JoseRueda1/riscv-single-cycle/README.md

# Procesador RISC-V single-cycle en SystemVerilog

Parcial 4 – Arquitectura de Computadoras, UNIS.
Autor: José Rueda (carné 18123).

Procesador RISC-V de **un solo ciclo** (single-cycle) descrito en SystemVerilog, basado en el capítulo 7 de *Digital Design and Computer Architecture* (Harris & Harris) y en el repositorio de referencia indicado en el curso. Cada instrucción se completa en un ciclo de reloj: fetch, decode, execute, memory y write-back.

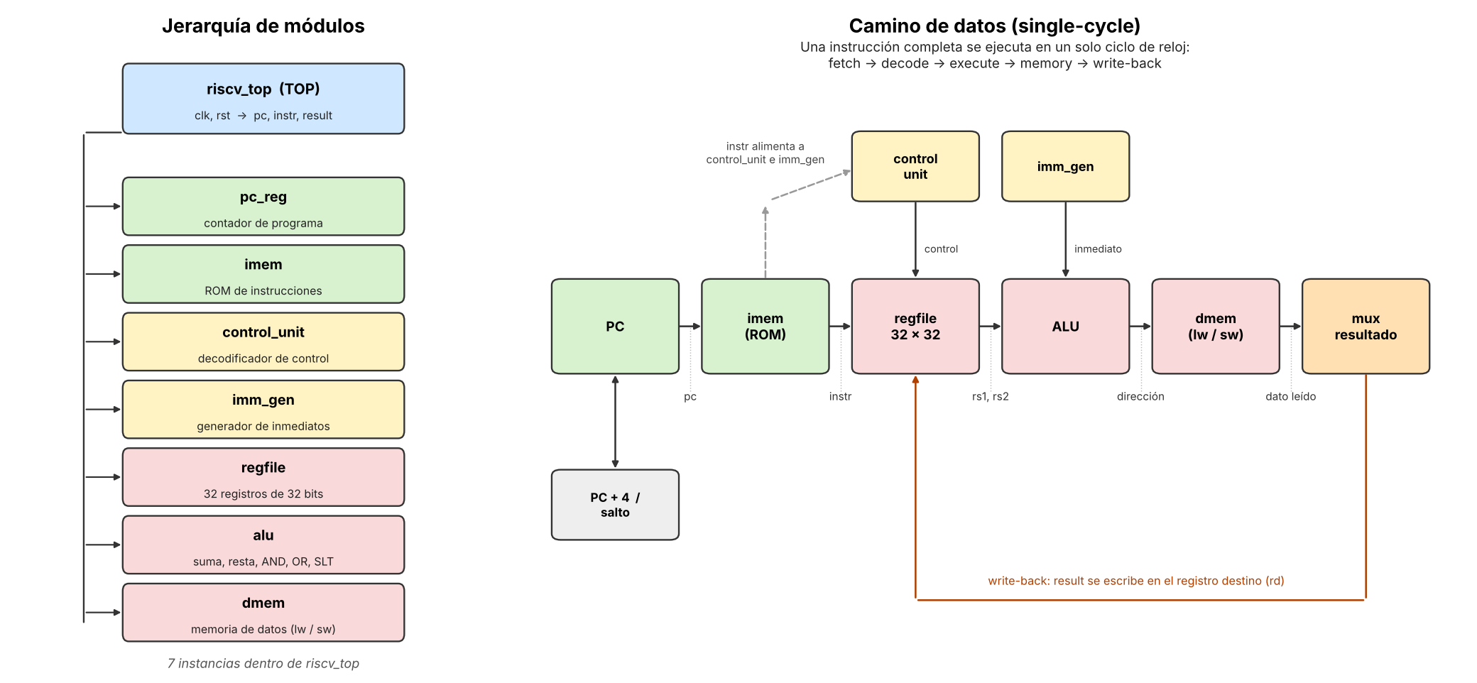
[picture p1: diagrama_jerarquia_y_datapath.png]
Jerarquía y camino de datos


## Instrucciones soportadas

Se implementó el subconjunto del video, más `addi` y `jal`, que el mismo video presenta como las siguientes en agregarse.

| Tipo | Instrucciones |
|---|---|
| Aritmético-lógicas (R) | `add`, `sub`, `and`, `or`, `slt` |
| Con inmediato (I) | `addi` |
| Memoria | `lw`, `sw` |
| Saltos condicionales (B) | `beq` |
| Salto incondicional (J) | `jal` |

Una instrucción no soportada se ejecuta como si fuera un NOP: no escribe registros ni memoria.

## Archivos

| Archivo | Descripción |
|---|---|
| `riscv_top.sv` | **TOP**. Conecta todos los bloques. Puertos: `clk`, `rst`, y salidas de observación `pc`, `instr`, `result`. Parámetro `DMEM_WORDS` (por defecto 16) |
| `pc_reg.sv` | Contador de programa, reset síncrono |
| `imem.sv` | Memoria de instrucciones (ROM combinacional con el programa de prueba) |
| `control_unit.sv` | Decodificador principal y decodificador de la ALU |
| `imm_gen.sv` | Generador de inmediatos (tipos I, S, B y J) |
| `regfile.sv` | Banco de 32 registros de 32 bits, 2 lecturas combinacionales y 1 escritura síncrona; `x0` siempre vale 0 |
| `alu.sv` | ALU: suma, resta, AND, OR y SLT con signo |
| `dmem.sv` | Memoria de datos (lectura combinacional, escritura síncrona) |
| `tb_riscv_top.sv` | Testbench autoverificable |
| `expected.svh` | Valores esperados (registros y memoria) generados por el simulador de referencia |
| `gen_program.py` | Mini ensamblador RV32I + simulador de referencia en Python; genera `imem.sv`, `expected.svh` y `program.hex` |
| `program.hex` | Programa de prueba en hexadecimal |
| `files.f` | Lista de archivos para VCS |
| `resultado_simulacion_*.log` | Salida de las simulaciones |

## Programa de prueba

El programa (41 instrucciones, 73 ciclos hasta su bucle final) ejercita todas las instrucciones:

- Operaciones aritmético-lógicas con valores positivos y negativos (`add`, `sub`, `and`, `or`, `slt` con signo).
- `sw` y `lw` con comprobación de lo leído.
- `beq` tomados y no tomados (cuatro en el código, uno de ellos dentro del bucle).
- `jal` con enlace.
- Un bucle que suma 10 + 9 + ... + 1 y guarda **55** en la memoria de datos.

## Cómo verificarlo

El testbench ejecuta el programa hasta el bucle final y compara **todos los registros escritos y la memoria de datos** contra los valores que calcula el simulador de referencia en Python (`gen_program.py`), que es independiente del RTL. Termina con la línea `Errores: N`.

### Icarus Verilog

```sh
iverilog -g2012 -o sim.vvp -s tb_riscv_top pc_reg.sv regfile.sv imm_gen.sv alu.sv control_unit.sv dmem.sv imem.sv riscv_top.sv tb_riscv_top.sv
vvp sim.vvp
```

### Synopsys VCS / Verdi

```sh
vcs -full64 -sverilog -kdb -debug_access+all -f files.f -o simv
./simv -no_save
verdi -dbdir simv.daidir -ssf dump_riscv.fsdb &
```

### AMD Vivado

Se creó un proyecto RTL para el Artix-7 `xc7a35tcpg236-1`. Archivos de diseño: los 8 `.sv` del procesador (`riscv_top` como top). Archivos de simulación: `tb_riscv_top.sv` y `expected.svh`. Restricción de reloj en `riscv.xdc`:

```
create_clock -period 12.000 -name clk [get_ports clk]
```

## Resultados

### Verificación funcional

| Herramienta | Resultado |
|---|---|
| Icarus Verilog 12 | `Errores: 0` (73 ciclos, 776 ns) |
| Synopsys VCS X-2025.06-SP2-6 | `Errores: 0` (73 ciclos, 776 ns) |
| Vivado Simulator 2025.1 | `Errores: 0` (73 ciclos, 776 ns) |

Para comprobar que el testbench detecta fallas, se introdujeron 7 errores a propósito en el diseño (`sub` implementado como suma, `slt` sin signo, `beq` invertido, `jal` que guarda el PC equivocado, inmediato de `sw` mal armado, `or` implementado como `and` y `lw` que devuelve la salida de la ALU). El testbench detectó los 7.

### Evidencia de VCS y Verdi

Primeras instrucciones: `pc` avanza de 4 en 4, `instr` muestra cada instrucción y `result` el dato que se escribe (10, 5, 15, 5, 0, 15, 1, 0, -3, ...).

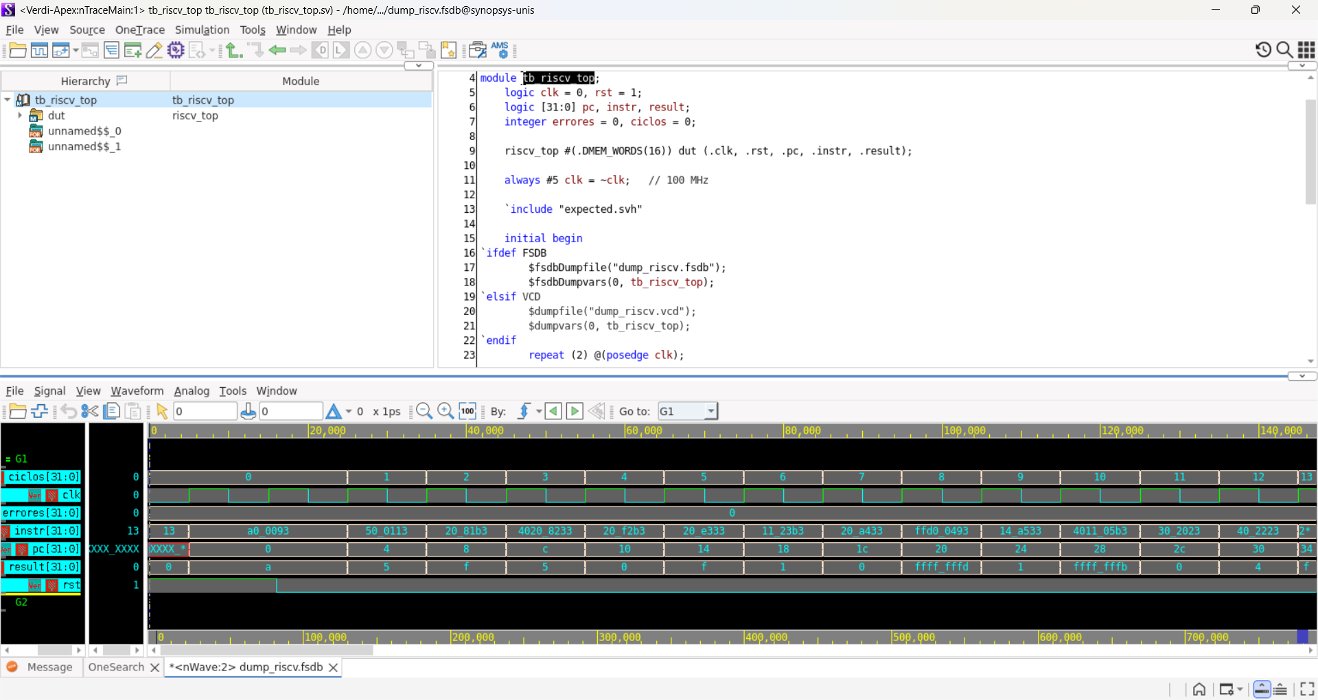
[picture p2: evidencia/01_verdi_primeras_instrucciones.png]
Verdi: primeras instrucciones


Programa completo (0 a 776 ns): `ciclos` llega a 73, `errores` se mantiene en 0 y `pc` termina en `a0`, el bucle final.

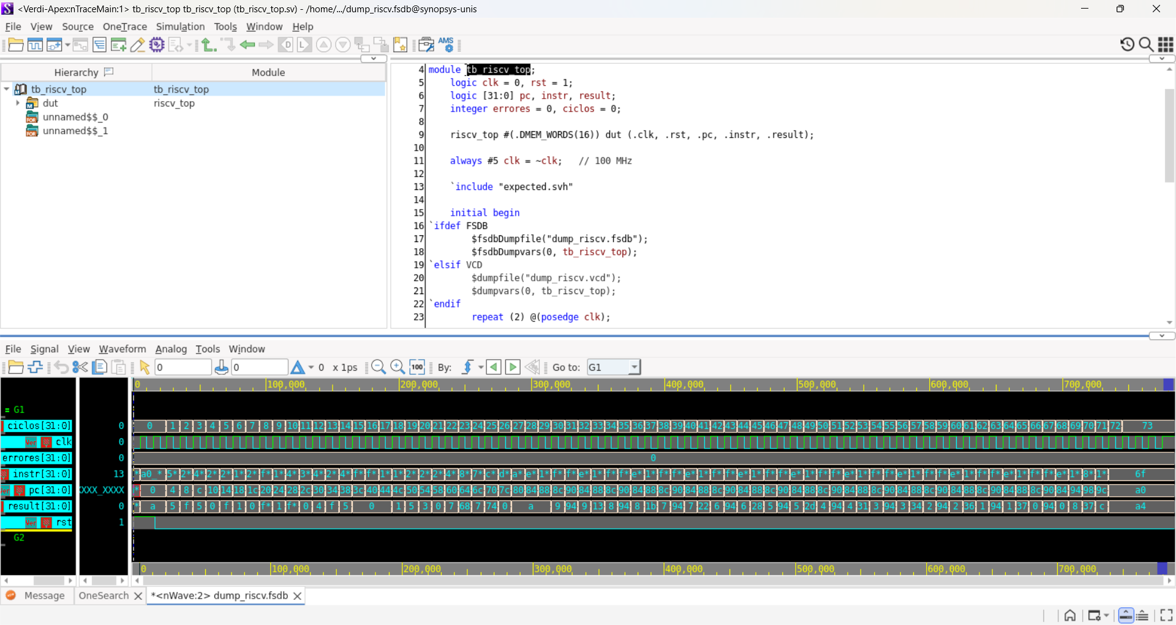
[picture p3: evidencia/02_verdi_programa_completo.png]
Verdi: programa completo


### Vivado: simulación

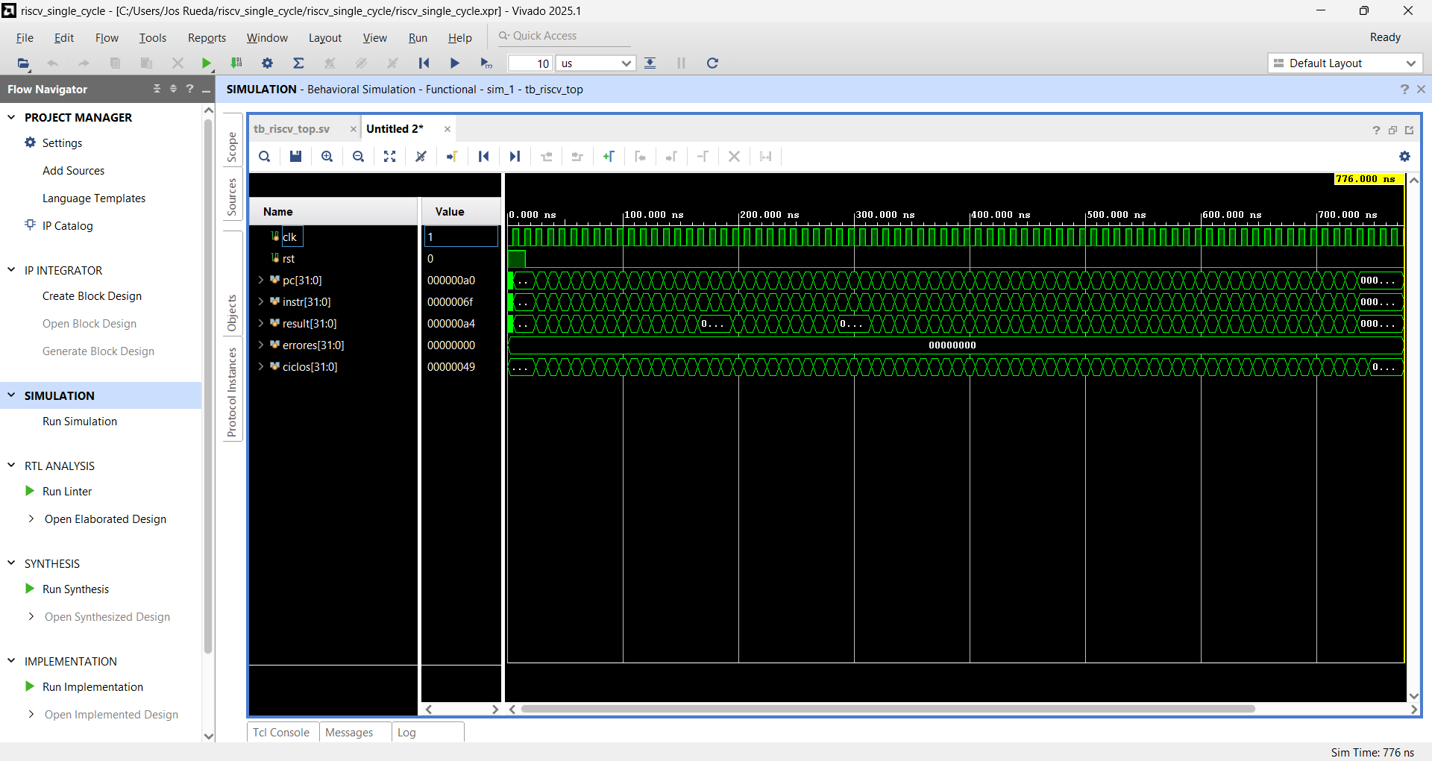
[picture p4: evidencia/vivado_simulacion.png]
Vivado: simulación


### Vivado: síntesis e implementación (xc7a35tcpg236-1)

| Recurso | Usado | Disponible | % |
|---|---|---|---|
| LUT | 498 | 20,800 | 2.39 |
| LUTRAM | 80 | 9,600 | 0.83 |
| FF | 32 | 41,600 | 0.08 |
| IO | 98 | 106 | 92.45 |
| BUFG | 1 | 32 | 3.13 |

Los 32 flip-flops son los del contador de programa. Vivado implementó el banco de registros y la memoria de datos como memoria distribuida (LUTRAM), por eso casi no usa FF. El IO es alto porque el módulo expone `pc`, `instr` y `result` (32 bits cada uno) además de `clk` y `rst`.

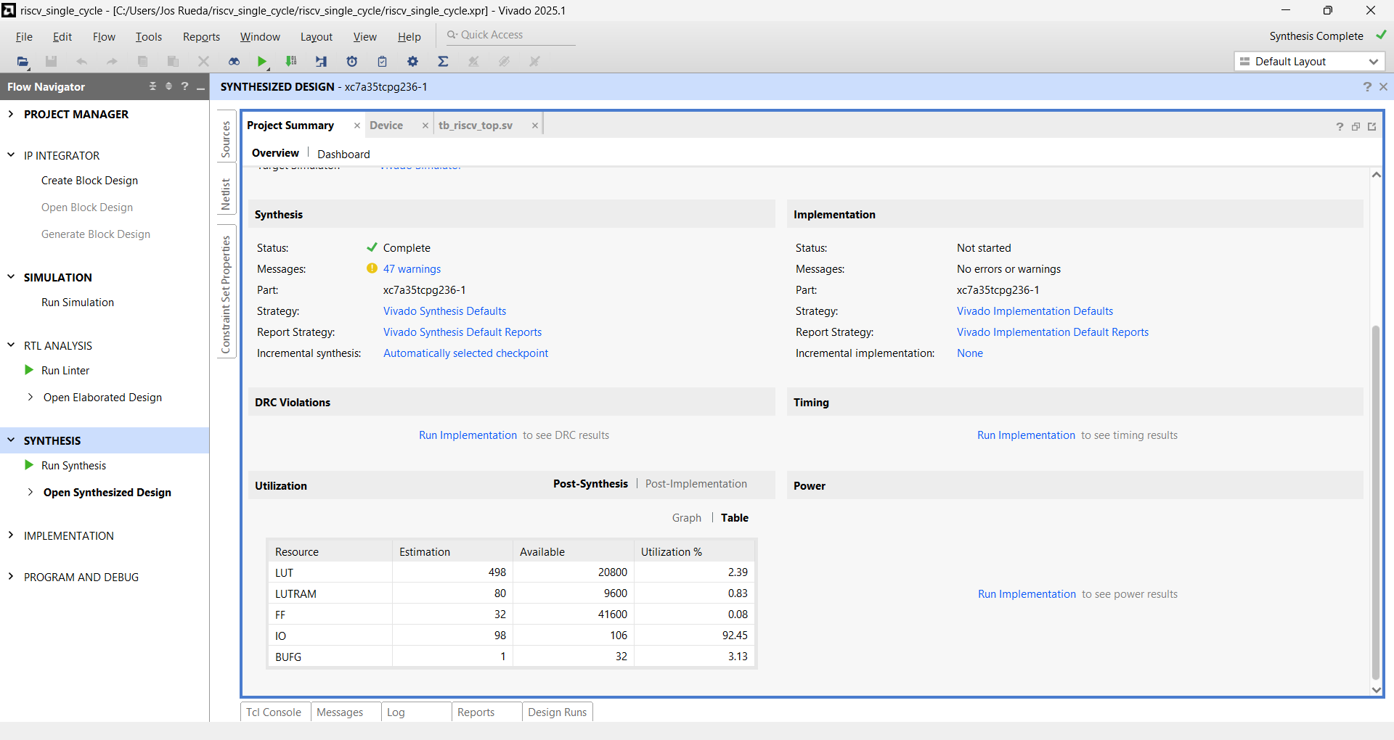
[picture p5: evidencia/vivado_sintesis_utilizacion.png]
Vivado: utilización tras la síntesis


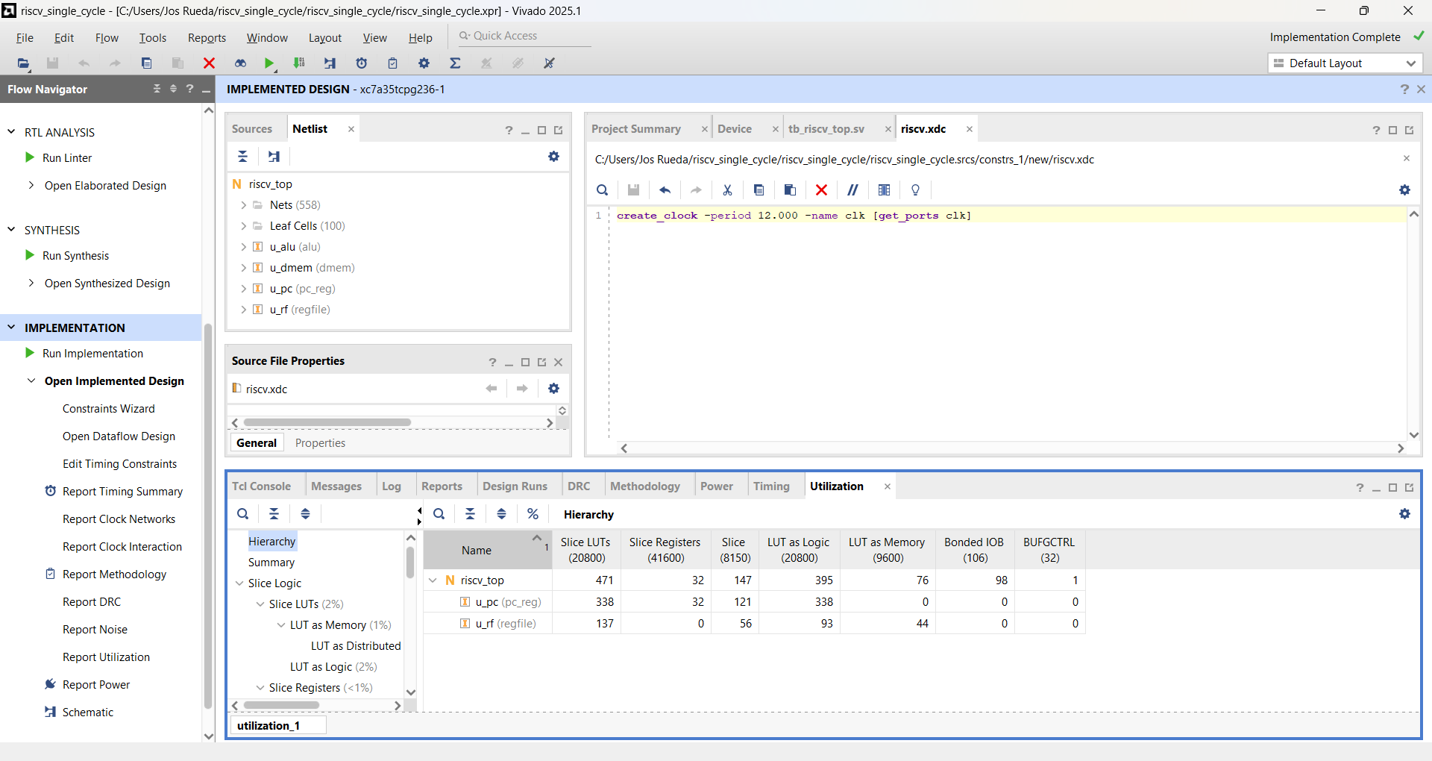
[picture p6: evidencia/vivado_impl_utilizacion.png]
Vivado: utilización tras la implementación


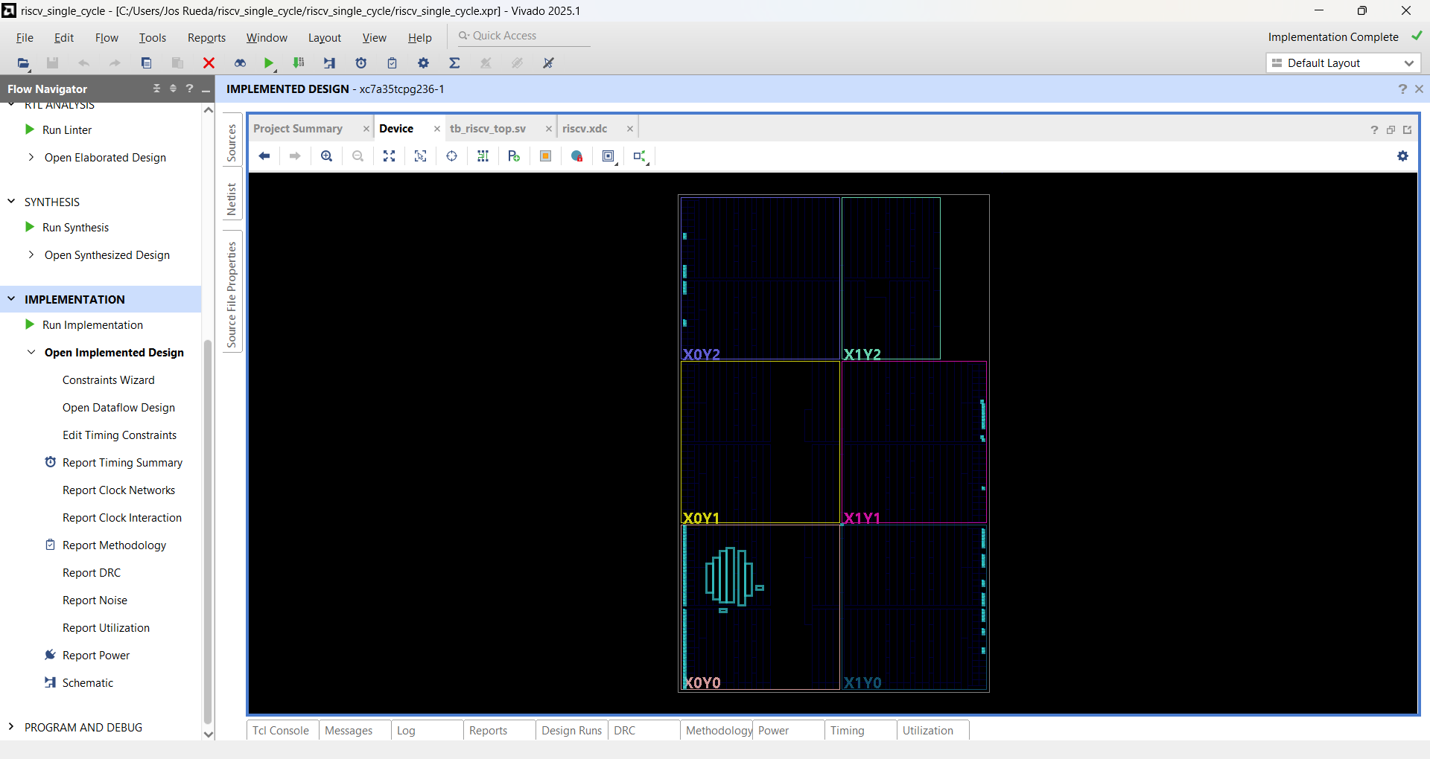
[picture p7: evidencia/vivado_impl_device.png]
Vivado: diseño colocado en la FPGA


### Vivado: timing

| Periodo de reloj | Frecuencia | WNS (setup) | WHS (hold) | Resultado |
|---|---|---|---|---|
| 10 ns | 100 MHz | -0.907 ns | +0.277 ns | no cumple (84 caminos) |
| 12 ns | 83.3 MHz | **+0.331 ns** | +0.277 ns | cumple |

En un procesador single-cycle el periodo del reloj lo fija el camino más largo: leer la instrucción, leer registros, ALU, memoria de datos y escritura de vuelta. A 100 MHz ese camino no cabe (le faltan 0.907 ns); con 12 ns sí.

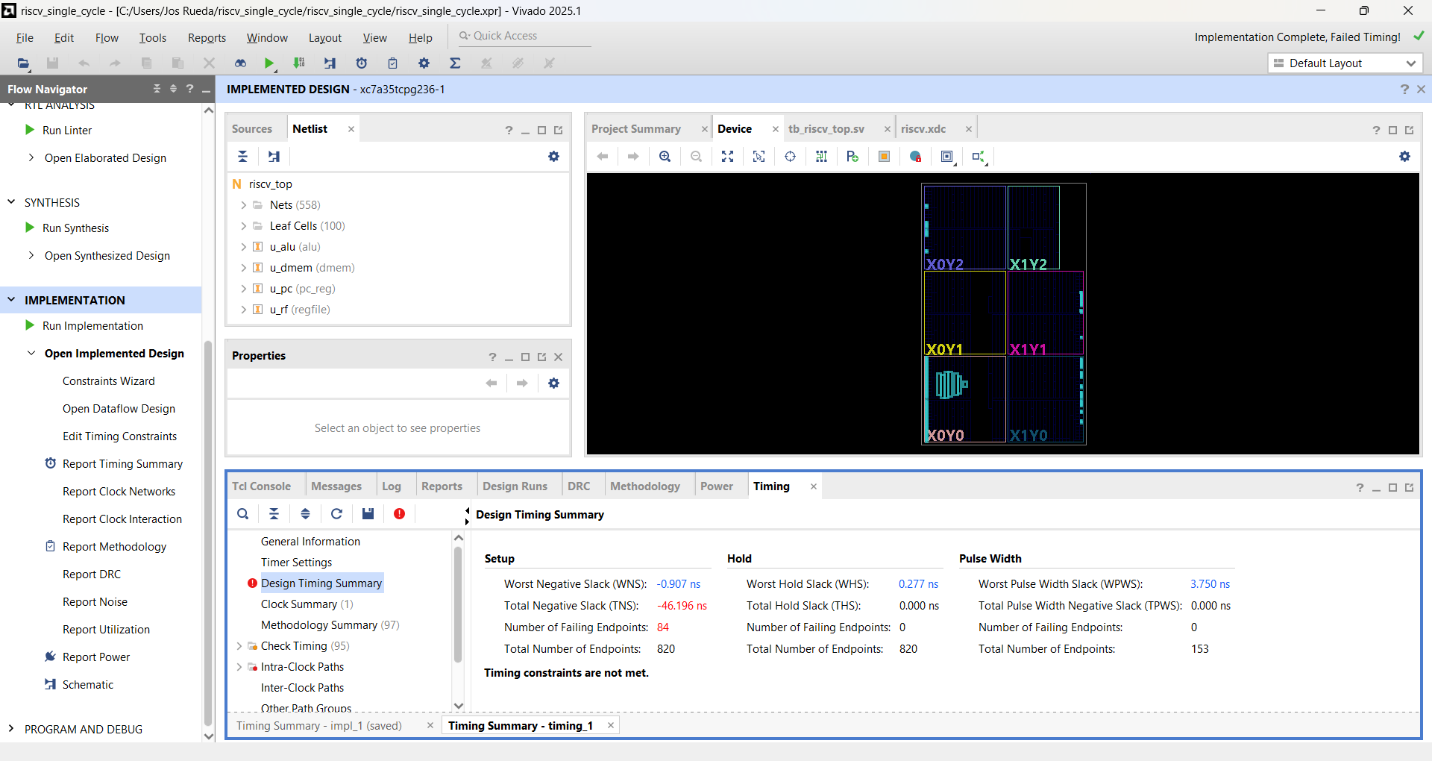
[picture p8: evidencia/vivado_timing_100MHz.png]
Vivado: timing a 100 MHz


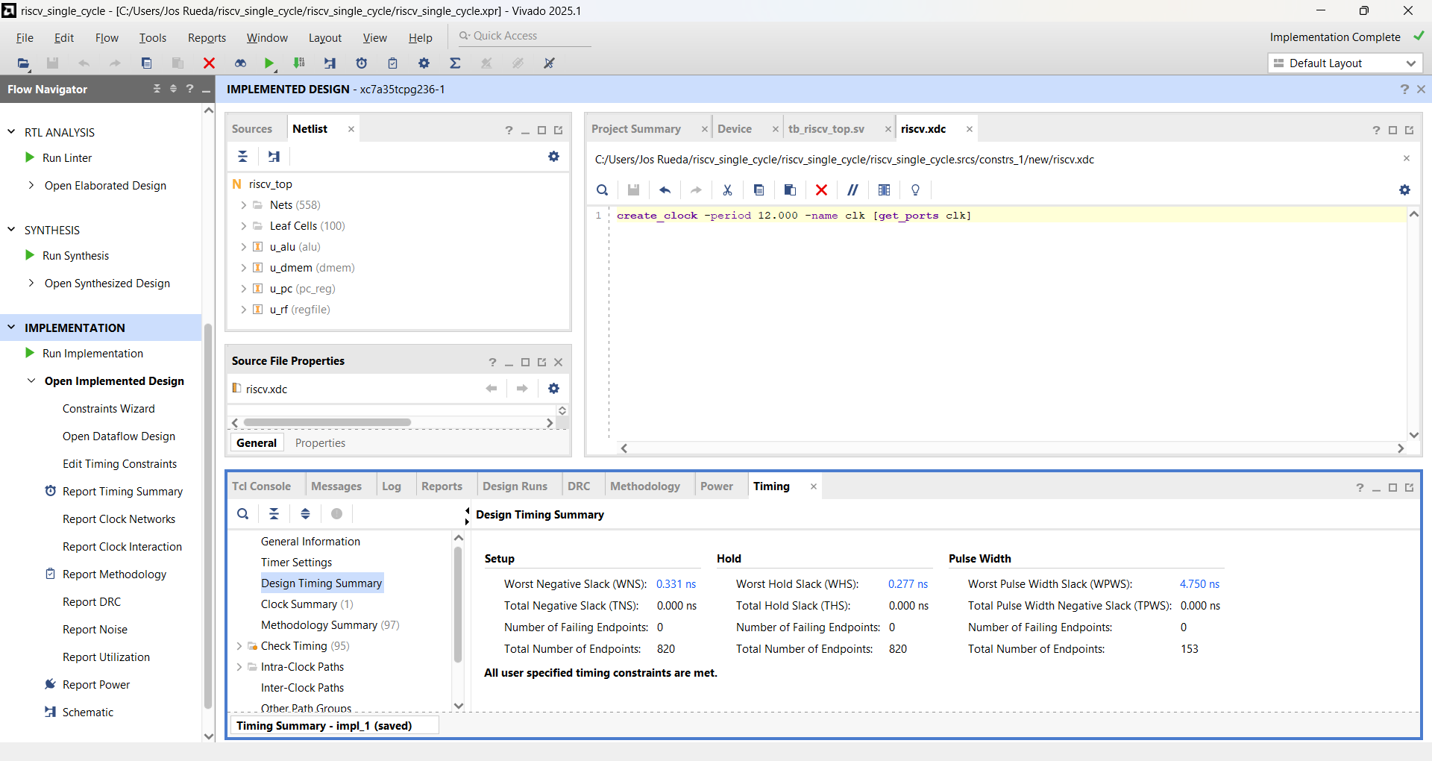
[picture p9: evidencia/vivado_timing_83MHz.png]
Vivado: timing a 83 MHz


## Parte 2: diseño físico en Synopsys

Flujo: Design Compiler (síntesis) → VCS (simulación del netlist) → IC Compiler II (diseño físico). Librería de celdas M31LLSC750GL150MS, corner 25 °C / TT / 1.8 V. Los scripts, reportes y salidas están en la carpeta [`parte2_synopsys/`](parte2_synopsys/); el diseño físico con el PDK de GF está en [`pdk_gf/`](parte2_synopsys/pdk_gf/).

### Síntesis (Design Compiler)

Script: `dc_riscv.tcl`. El periodo del reloj se pasa con la variable `CLK`.

| Periodo | Resultado |
|---|---|
| 25 ns | No cumple: WNS -10.99 ns (ruta crítica de 28.49 ns hacia `result`, 30.28 ns hacia los registros) |
| 42 ns (~24 MHz) | Cumple: WNS 0.00, TNS 0.00, 0 rutas violadas (setup y hold) |

Con 42 ns el área es de 162,160 µm² y hay 1,536 flip-flops: 992 del banco de registros (x1 a x31), 512 de la memoria de datos y 32 del PC. A diferencia de Vivado, aquí el banco de registros y la memoria quedan como flip-flops y no como LUTRAM. La única línea marcada `VIOLATED` en `report_constraints.rpt` es `max_leakage_power`, una restricción por defecto en 0 que no definimos nosotros.

### Simulación del netlist sintetizado (VCS)

Se simuló `riscv_top_dc.v` con el modelo Verilog de las celdas M31 y el mismo programa de prueba: **0 errores, 73 ciclos**, con los mismos valores esperados que el RTL (x3=15, x4=5, suma 1..10 = 55, mem[2]=55, x30=7, x31=7).

DC convierte los arreglos en vectores planos (`regs[991:0]`, `mem[511:0]`) y numera el registro `r` desde el final, así que `tb_syn.sv` (copia del testbench) lee `regs[(31-r)*32 +: 32]` y `mem[(15-i)*32 +: 32]`. También usa un reloj de 100 ns, porque el diseño necesita unos 42 ns. Resultado en `parte2_synopsys/resultado_simulacion_postsintesis.log`.

### Diseño físico (IC Compiler II) con el PDK de GlobalFoundries

Script: `parte2_synopsys/pdk_gf/riscv_icc2_gf.tcl`, con el netlist y el SDC generados por DC. Usa el PDK 150MCU de GlobalFoundries (www.gf.com, paquete PlaceRoute/ICC2, pila de metales `1p5m_1tm_9k_sp_sm_OPTB`: 5 metales + top metal de 9 kÅ) y la librería de celdas estándar de M31 (`M31LLSC750GL150MS`, NDM de M31).

| Elemento | Origen |
|---|---|
| Tech file | GF: `gf150mcu_1p5m_1tm_9k_sp_sm_OPTB_7t_M31_ndm.tf` |
| Parásitos | GF: TLU+ corner `typ` + `mdb2itf.map` (`read_parasitic_tech`) |
| Reglas de antena | GF: `gf150mcu_antenna_rules_..._OPTB.tcl` |
| Mapa de capas del GDSII | GF: `..._gds2OutLayer.map` |
| Celdas estándar | M31 (NDM) |

Flujo: floorplan, malla de alimentación (METAL4/METAL5), `place_opt`, `clock_opt` (árbol de reloj completo), `route_auto`, `route_opt`, fillers, chequeos y salidas. Con los parásitos del PDK ya es posible construir el árbol de reloj y reportar el timing posterior al ruteo.

**Timing posterior al ruteo** (periodo de 42 ns, parásitos TLU+ `typ`):

| Métrica | Valor |
|---|---|
| Ruta crítica | 36.43 ns, 33 niveles de lógica |
| Slack de setup | +0.04 ns, 0 rutas violadas (TNS 0.00) |
| Hold | 0 violaciones |

**Árbol de reloj:** 1,536 sinks, 5 niveles, 88 buffers de reloj (2,197 µm²), latencia máxima 7.71 ns, skew global 4.04 ns, 0 violaciones de transición y de capacitancia. El skew es alto en términos absolutos porque las celdas de la librería son lentas en este corner (1.8 V), pero el timing cierra con el periodo de 42 ns.

**Resultados físicos:**

| Métrica | Valor |
|---|---|
| Área de celdas | 187,546 µm² (en síntesis: 162,160 µm²; el aumento viene de los buffers de reloj y de las reparaciones de timing) |
| Utilización del core | 58.02 % (core de 323,260 µm²) |
| Nets | 9,205 extraídas, 0 abiertas |
| DRCs | 0 |
| Violaciones de antena | 0 |
| Cortos / nets abiertas / rutas flotantes (LVS) | 0 / 0 / 0 |
| Potencia | 2.30 mW dinámica (1.08 mW interna + 1.22 mW de conmutación), 6.87 nW de fuga |

La potencia es una estimación con actividad por defecto (no se usó un archivo SAIF con la actividad real del programa).

Salidas en `parte2_synopsys/pdk_gf/`: `riscv_top_icc2_gf.v` (netlist), `riscv_top_icc2_gf.def`, `riscv_top_icc2_gf.sdc`, `riscv_top_gf.gds`, `icc2_gf_run.log` y los reportes en `reports_icc2_gf/`.

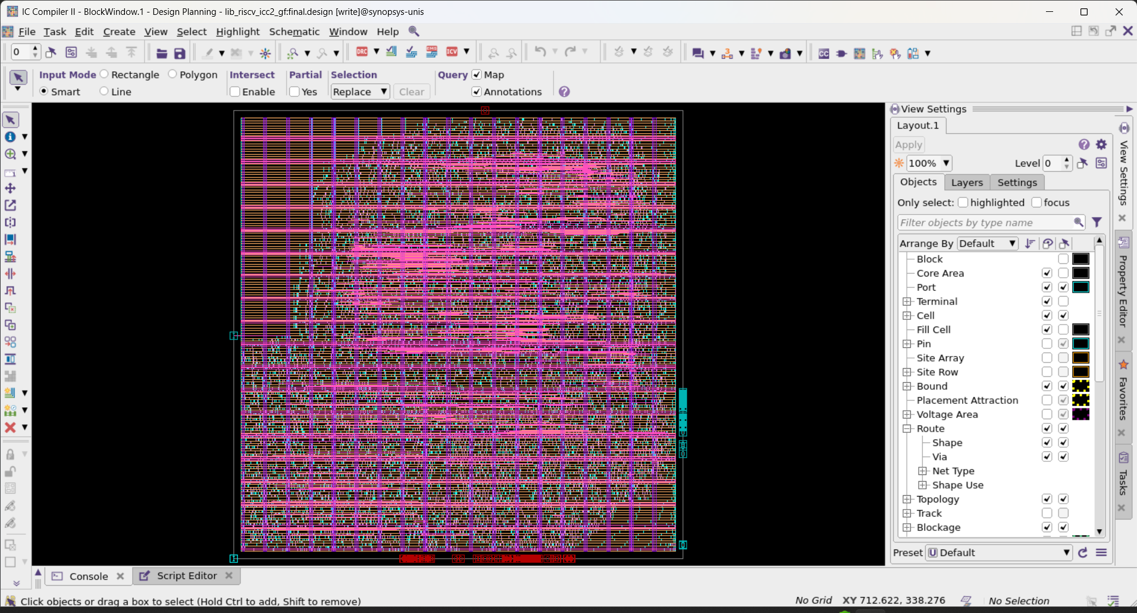
[picture p10: evidencia/p2gf_layout_completo.png]
Layout completo (PDK GF)


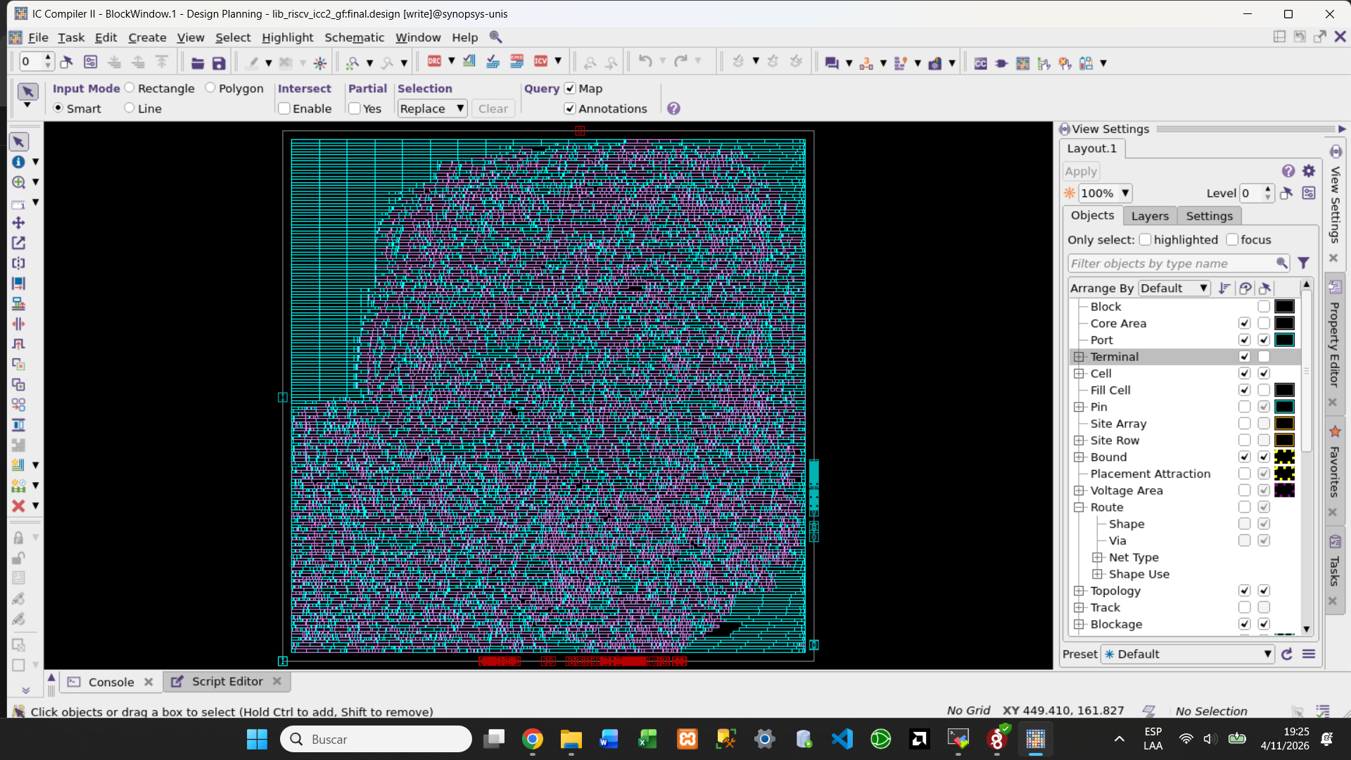
[picture p11: evidencia/p2gf_layout_celdas.png]
Celdas estándar y fillers, sin ruteo


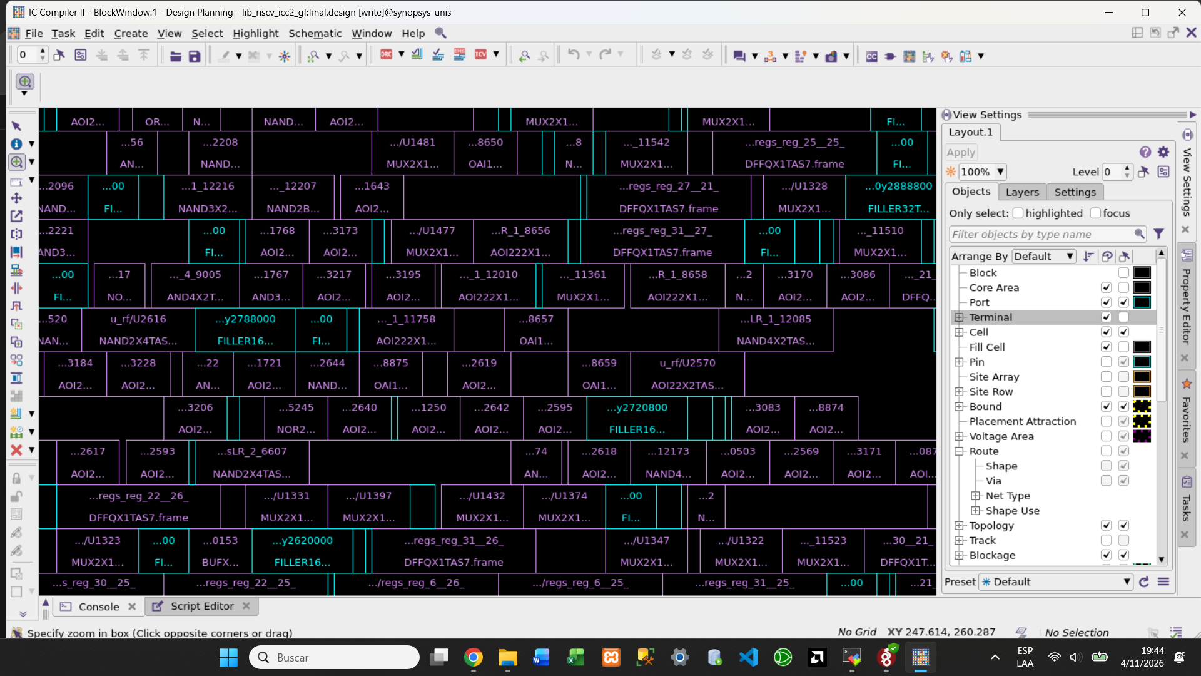
[picture p12: evidencia/p2gf_layout_zoom.png]
Acercamiento: compuertas, flip-flops DFFQX1TAS7 y fillers


### Corrida previa con los tech files del kit de M31

Antes de usar el PDK de GF se hizo una primera corrida (`riscv_icc2.tcl`, resultados en `reports_icc2/` y `riscv_top.gds`) con el tech file que trae el kit de M31. Ese kit no incluye parásitos (TLU+), así que el árbol de reloj (`clock_opt`) no se pudo construir y no hubo timing posterior al ruteo. Resultados: utilización 50.16 %, 8,418 nets ruteadas, 443,645 µm de cable, 67,778 vías, 0 DRCs, 0 cortos y 0 nets abiertas.

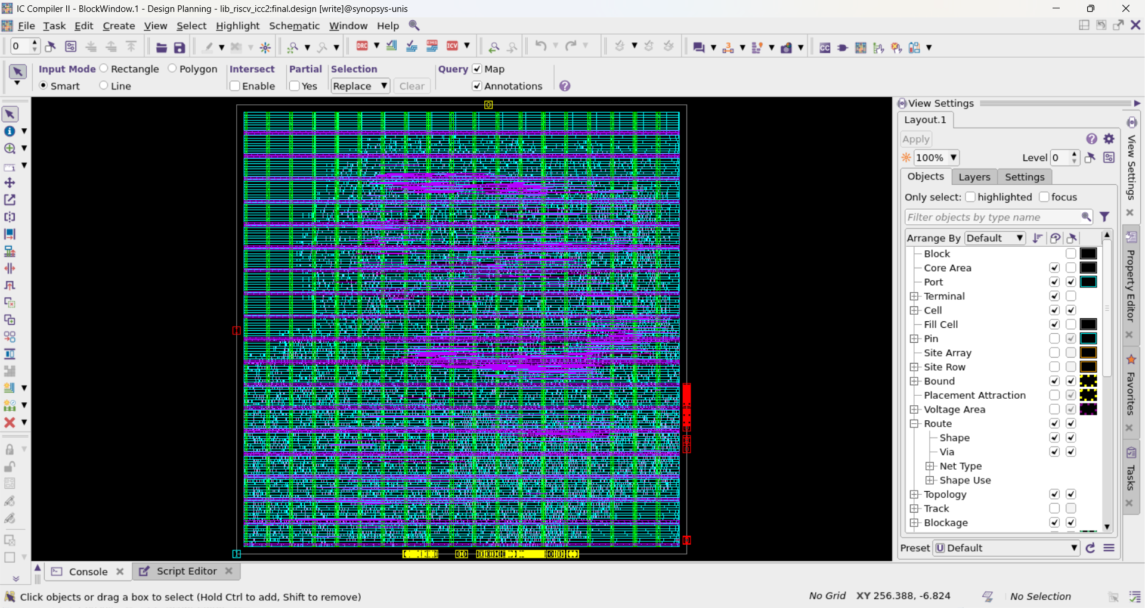
[picture p13: evidencia/p2_layout_completo.png]
Layout (corrida previa)


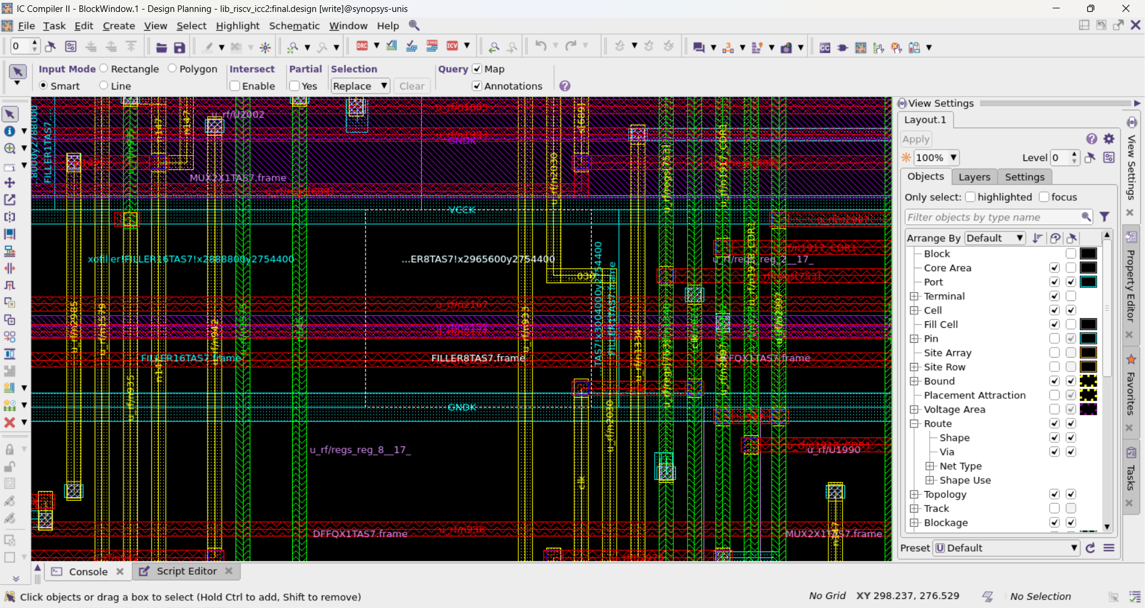
[picture p14: evidencia/p2_layout_zoom.png]
Acercamiento (corrida previa)


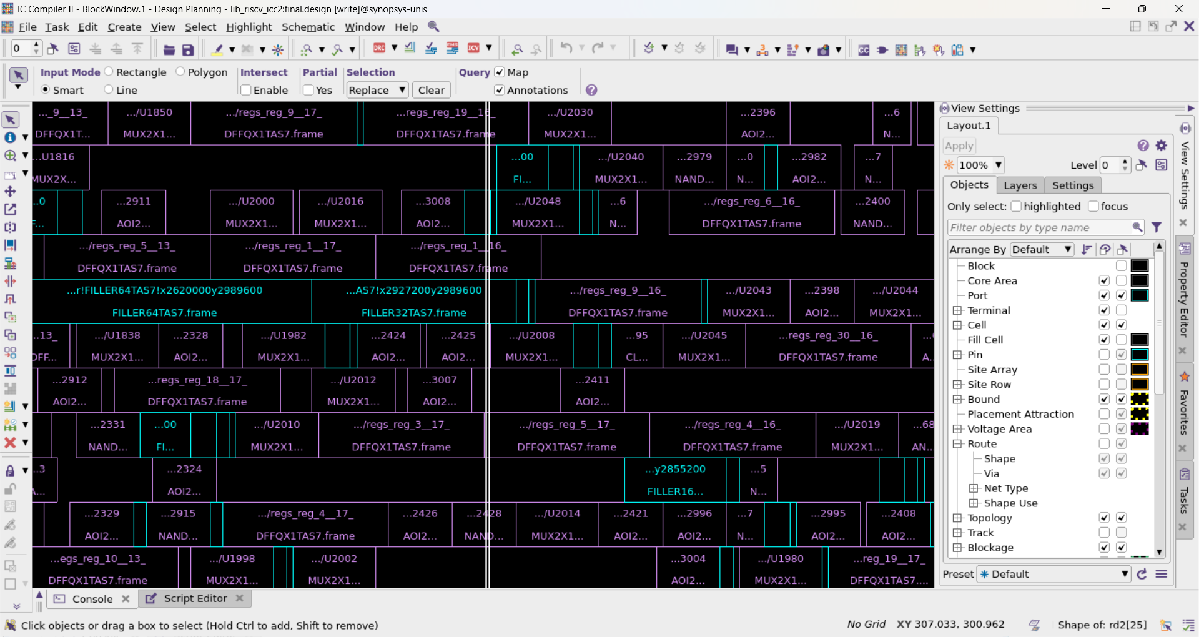
[picture p15: evidencia/p2_layout_celdas.png]
Filas de celdas y fillers (corrida previa)


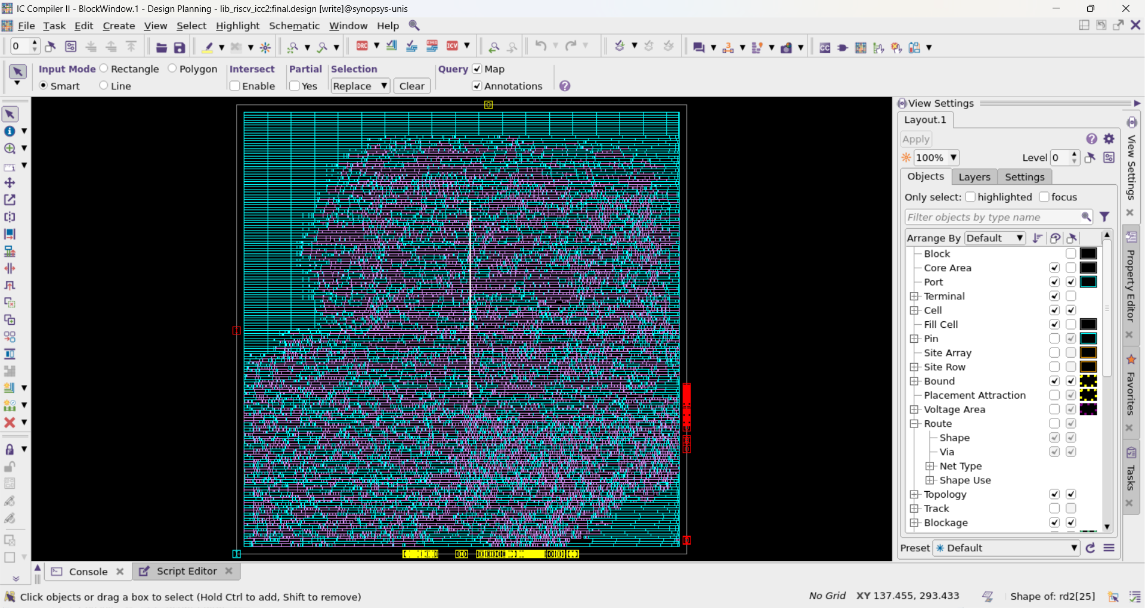
[picture p16: evidencia/p2_layout_placement.png]
Distribución de celdas sin ruteo (corrida previa)


### Limitaciones de esta parte

- El NDM de las celdas M31 se construyó con el tech file del kit de M31 y no con el de GF. Al abrir la librería ICC2 muestra las advertencias `FRAM-054` y `NDM-102` (inconsistencia de tecnología; falta la capa `poly`, que no interviene en place & route). Los nombres de los metales, las vías y las unidades coinciden entre ambos tech files, y el diseño sale sin DRCs ni cortos. Para eliminar la advertencia habría que reconstruir el NDM con el tech file de GF.
- Se usó un solo corner (TT, 1.8 V, 25 °C; parásitos `typ`). La librería LLSC750 es de 5 V y también está caracterizada a 3.3 V y 1.8 V.
- La potencia es una estimación sin actividad real de conmutación.
- El GDS exportado no incluye el layout interno de las celdas estándar, solo el ruteo y la colocación.

## Limitaciones

- Subconjunto de RV32I: 10 instrucciones en total. No hay accesos a byte ni media palabra, ni CSR ni excepciones.
- La memoria de instrucciones es una ROM con un programa fijo, generada por `gen_program.py`. Para otro programa hay que regenerarla.
- La memoria de datos es de 16 palabras por defecto y no tiene control de alineación.
- Los puertos `pc`, `instr` y `result` existen solo para observar el procesador; por eso el diseño usa muchos pines de la FPGA.
