JoseRueda1/riscv-single-cycle/pc_reg.sv

// Contador de programa: registro de 32 bits con reset sincrono
module pc_reg (
    input  logic        clk,
    input  logic        rst,
    input  logic [31:0] pc_next,
    output logic [31:0] pc
);
    always_ff @(posedge clk) begin
        if (rst) pc <= 32'h0000_0000;
        else     pc <= pc_next;
    end
endmodule
